riggles1/GunconDuino-With-Screen-Flash/README.md

# GunconDuino v2, With Trigger Screen Flash Support

PS1 Guncon controller as absolute Mouse coordinates via Arduino Pro Micro or Leonardo.
This repository is a fork based on the original work by Matheus Fraguas (sonik-br). 

The goal of this fork was to make the GunconDuino work with RetroArch's "shader (hold)" lightgun screen flash functionality.
This ensures XY-coordinates and trigger presses always get sent together. Meaning no more missed shots when shooting at dark areas, no matter how fast you shoot.
Due to emulation lag (setup+config dependent), the built-in flash in games doesn't work. This solution allows for any lightgun game to work when set up correctly. 

With this setup, the physical input lag of your intended shot direction is either sampled the same frame the trigger was pressed (if light is present) or up to 35ms (buffer delay, where screen flash happens), so the lag from a trigger press to XY position on screen is 0-2 frames (60Hz).

This script is set for 1-2 frames of input emu-lag (maximum at 60Hz, thanks to the bufferDelay that's set to 35ms. A maximum "2 frames".
There are alternate extended bufferdelay modes enabled by the A-button (at boot or after disabling the GunconDuino with A+B+Trigger), where bufferDelay becomes longer depending on how many times A was pressed before pulling the trigger.

 * Press A+B+Trigger to disable the guncon, then:
 * 0 A presses = default 2 frame bufferdelay, 
 1 A press = 3 frame bufferdelay, 
 2 A presses = 4 frame bufferdelay, 
 3 A presses = 5 frame bufferdelay, 
 4 A presses = 6 frame bufferdelay. 
 (60Hz frames)
 * Finally pull the trigger to confirm the selection. You can at any time disable it and select a different bufferdelay mode.
 * Set whatever bufferdelay depending on your setup lag, optimal setups will have 1-2 frames of input lag depending on the title, but for something like Carnevil that plays at 55Hz, use the 3 frame bufferdlay mode (1 A press) to compensate, since each frame takes longer at 55Hz.

To check that the GunconDuino isn't losing shots due to lag. Shoot repeatedly at a black spot in a game.

> NEW OPTIONAL FEATURE: Adding a Pedal input.
> By wiring something like a a 3.5mm port between GND and D6 on the Arduino Pro Micro and plugging in a generic ~$5 sustain pedal, you have an input that mirrors "middle mouse click/Guncon button B", useful for games like Time Crisis that made use of a pedal.

GunconDuino v2 in action: https://www.youtube.com/watch?v=mwm7y__UAsM 

My CRTEmudriver setup guide that I use for this can be found in the video description here: https://youtu.be/Fdo5z1mQ748

---

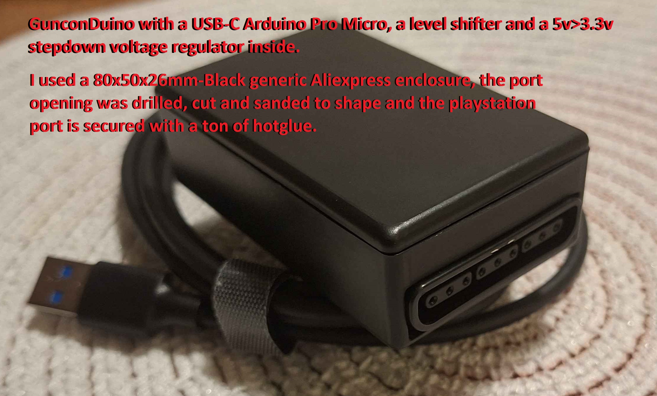
[picture p1: docs/Enclosure.jpg]
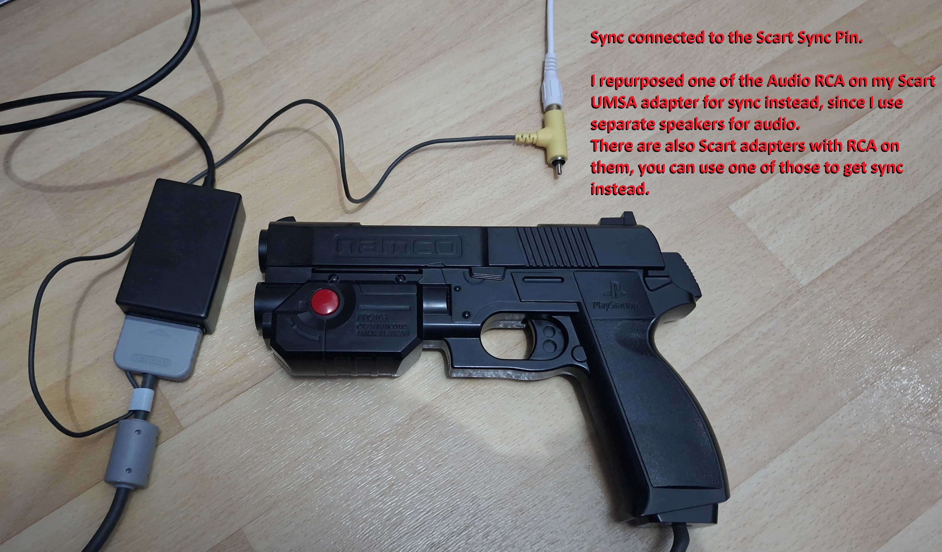
[picture p2: docs/GunconSync.jpg]
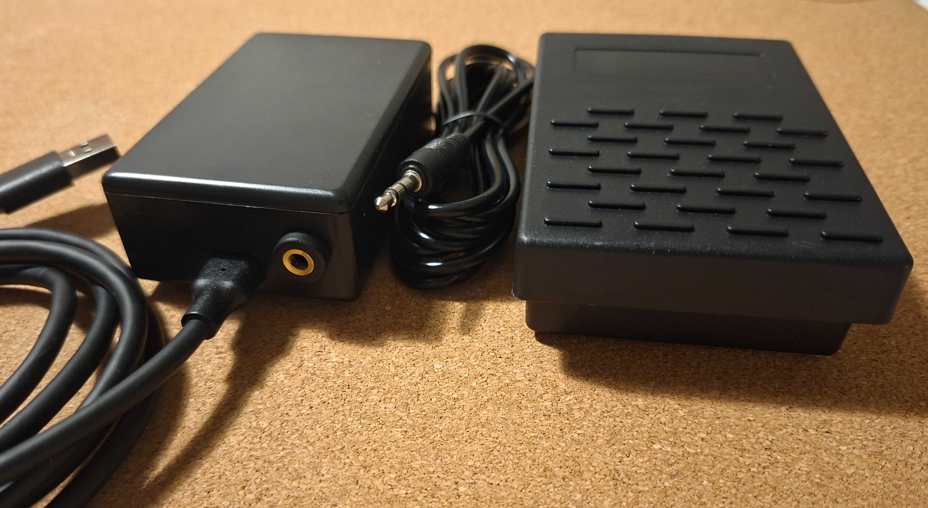
[picture p3: docs/3.5mmPedal.jpg]
   

---

## Software setup (RetroArch)

* In RetroArch Hotkeys map **"Shader (hold)"** to the keyboard key **L**.
* Choose a shader (example: `shaders/misc/color-mangler.slang`) and adjust brightness/gamma to taste.
* Save the shader for the game, then disable it in the game's override config: `video_shader_enable = "false"` in `gamename.cfg`.
* Use the **rawmouse** input driver, this allows using two GunconDuino units for 2-player games.
* Select the Arduino (might be called Leonardo) as your mouse device ID. 
* If playing a 480i game, disable the guncon first with the disable button combo, then boot up the game. Not doing this can result in the shot output only covering the top half of the screen.

### Latency and video driver recommendations

* Use native RGB output setups such as **CRTEmudriver** for minimal latency.
* Use  **d3d11** or **vulkan** as the video driver in RetroArch (setup and game dependent, I use both in my configs, all with optimal latency).
* Adjust `video_max_frame_latency = "0"`(used with d3d11, optimal value for most things) `video_max_swapchain_images = "2"` (used with vulkan, optimal value for most things). 
* The wrong values for the settings above can cost several frames of latency, check these values for individual games in the `Preset-configs\config/MAME\` folder.
* Try with and without frame delay, shoot at dark targets, shoot in the bottom right corner (it should always register).
* Change threaded rendering in both RA and the MAME core options+.ini.

Preset configs for this setup are included in the `Preset-configs` folder, copy or compare them with your own configs.

---

## Usage & mappings

**Calibration:** Start by standing from the distance you will play at, move the guncon across a fully lit screen fairly slowly (left-right, top-bottom) edge to edge to capture min/max screen values. 
Then repeat the process with the guncon pointing much closer to the screen. The most accurate readings will be from the first distance you calibrated at.
Once calibrated, press the trigger **10 times** to lock the calibration (the calibration will also lock itself at any point, whenever the lock counter reaches 10). 
If the Arduino is disconnected, it requires recalibration. Disable-reenable of the the guncon does not require recalibration.

Some games have their own built in calibration tool, often hidden within a service menu, look up how to do this is accessed on a per game basis. The provided savefiles in this project have my own calibrations, test with these.

**Trigger**: Left-Click (and keyboard "L" pulse for shader flash)

**A**: Right-Click

**B**: Middle-Click

**Press "Trigger"** after plugging or doing the disable combo: default buffer mode **35ms** maximum (for 60Hz 0-2 frame game lag, shots still release as soon as light is sensed within 0-35ms).

**Press "A" 1-4 times followed by "Trigger"** after plugging in or doing the disable combo: 1 A press = 3 frame bufferdelay, 2 A presses = 4 frame bufferdelay, 3 A presses = 5 frame bufferdelay, 6 A presses = 6 frame bufferdelay. (60Hz frame-time, 55Hz frames are longer, select a bufferdelay that's +1 in that case)

To **Disable/re-enable** the GunconDuino: Press A+B+Trigger to disable the GunconDuino (unsticks mouse controls), press either "Trigger" for the normal bufferdelay or "A" (1-4 times) then "Trigger" for either of the extended bufferdelays.

**XY-Freeze mode** (toggle): Hold "A + B" for 2 seconds to toggle infinite XY-Freeze. 
>This freezes XY-coordinates when light (XY) is lost and resumes XY-updates either as soon as the guncon can
>see light again, either something bright enough in the game or the trigger flash.
>
>  Useful for games that require continuous shooting, games that used IR or analog stick tracking originally (like Jurassic Park 1994, though honestly it still plays bad with this as that game was made for analog sticks).
>  It's  necessary for some other games such as Crypt Killer or Carnevil which has a gattling/machine gun that strobes the screen at a slow rate.
>  XY-freeze-mode makes it keep XY-coordinates in-between strobe flashes, so that XY is always there when the game asks for position.
>
> Adding a Pedal input.
> By wiring something like a a 3.5mm port between GND and D6 on the Arduino Pro Micro and plugging in a generic ~$5 sustain pedal, you have an input that mirrors "middle mouse click/Guncon button B", useful for games like Time Crisis that made use of a pedal.

**MAME / RetroArch mapping notes:**

* MAME lightgun games that used real lightguns (e.g. Point Blank) use **GunX** and **GunY**. `GUNCODE_1_XAXIS and GUNCODE_1_YAXIS` in `saves/mame/cfg/` the .cfg for the game.
* In `\system\mame\ini\mame.ini`, enable lightguns (not mouse). Use my included `mame.ini` if you don't have it.
* In the MAME core options, enable the .ini read (so it reads it).
* In RetroArch's MAME core input settings, map **GunX** and **GunY** (do NOT map as MouseX/MouseY).
* You will likely need to manually edit the RetroArch and MAME-core configs, mapping via the built-in configurators may not add the required lightgun axes.

**PCSX-ReARMed (PS1, RetroArch) mapping notes**
* This core supports rawinput mouse input for guncons, meaning two players are supported (I couldn't get guncons working with swanstation)
* Buttons are mapped to plugged in controllers as well the so that you can do the trigger+A+B combo through the controller to exit the arcade mode in Point Blank, as this combo is what otherwise disables the guncon.
* I've included what settings I use in order to make PS1 lightgun games never miss an input ```video_driver = "d3d11", video_max_frame_latency = "1, video_frame_delay_auto = "true, video_frame_delay = "3"```
* Runahead works with PCSX-ReARMed, I've set it to 1 in the configs included in this package.
* The following mappings are necessary for PCSX-ReArmed to recognize the trigger, A and B buttons. Inputs are also mirrored on the P1 and P2 controllers within the PCSX-ReARMed.cfg override in ```\config```.

**Flycast notes**
If the XY tracking is limited to the top portion of the screen, exit the game/core, disable the GunconDuino (A+B+Trigger), start the game again and enable the guncon while it's running (trigger press, or A button presses then trigger if selecting a different buffedelay).

Edit the PCSX-ReARMed.cfg accordingly (already set in the included config override):
```
//Guncon Player 1 Trigger mapping:
  input_player1_gun_trigger_mbtn = "1"   //mousebtn-left-click (mouse ID 1)
  input_player1_gun_trigger_btn = "3"

//Guncon Player 1 A button mapping:
  input_player1_gun_aux_a_mbtn = "2"   //mousebtn-right-click (mouse ID 1)
  input_player1_gun_aux_a_btn = "4"

//Guncon Player 1 B button mapping:
  input_player1_gun_aux_b_mbtn = "3"   //mousebtn-middle-click (mouse ID 1)
  input_player1_gun_aux_b_btn = "5"

//Guncon Player 2 Trigger mapping:
  input_player2_gun_trigger_mbtn = "1"   //mousebtn-left-click (mouse ID 2)
  input_player2_gun_trigger_btn = "3"

//Guncon Player 2 A button mapping:
  input_player2_gun_aux_a_mbtn = "2"   //mousebtn-right-click (mouse ID 2)
  input_player2_gun_aux_b_btn = "5"

//Guncon Player 2 B button mapping:
  input_player2_gun_aux_b_mbtn = "3"   //mousebtn-middle-click (mouse ID 2)
  input_player2_gun_aux_b_btn = "5"

//Guncon shader flash activation (any core, you can include this within an .cfg override instead, see example configs)
input_shader_hold = "l"
```

---

## How it works

* On any hardware trigger press the Arduino sends a keyboard **L** pulse (to trigger the shader flash) followed by a buffered mouse click so the game receives valid XY coordinates and a click.
* Trigger presses are continuously buffered, meaning that you can spam the trigger without missing shots even if your setup lag is 3 frames.
* If light is sensed before expected buffer release, it cancels the buffer and releases the shot instantly (the buffer is just a fallback, accommodating for laggier setups)
* The buffer releases at **35 ms**, which works with 1-2 frames of lag, but if you have to you can use any of the extended bufferdelay mode meant for lower Hz games like Carnevil (55Hz 256p). But only do this if you've fully optimized your setup and configs for lag first.
* Light sensing has a 35ms leniency window in case light is lost before the trigger press gets sent to the game (XY will always immediately update again at any frame light is sensed, it's just there if light is lost very momentarily, so there's zero latency drawbacks with this).

* The actual input sensing lag is 2 frames due to that being the exact moment when your physical aim+trigger is captured. However when shooting at dark targets the game will react 2 frames later after this input capture.
In the future maybe we could have a screen flasher that bypasses the 2 frame game render pipeline. 
That said with extensive testing and comparing Point Blank MAME with my real PS1, I can zip the aim left-right as fast as possible, firing at the edges and it'll always hit them, it shoots where I intend to at high speeds and never fails delivering the shot. Largely thanks to the actual moment XY is sampled for the trigger pull is either instantly (light target already there) or at most 35ms later (dark target), additional frames are just the game reacting to the input.

Dark target (with 2 frames of emulation input lag):

```
>Trigger press
>2 Frames emu-lag (input for shader)
>1 Frame flash, XY+Trigger states sent
>2 Frames emu-lag (inputs sent to game)
>Game reaction
```

Light target (with 2 frames of emulation input lag):
```
>Trigger press
Either: XY+Trigger states gotten and sent the same frame as the Trigger press.
(if the screen could be sampled this same frame, depends on how far the CRT has drawn the frame)
Or XY+Trigger states gotten 1 frame later instead.
>2 Frames emu-lag (inputs sent to game)
>Game reaction
```

However I've included an optimization where it will instantly send the trigger and XY states if the Guncon already has light before the flash shader.
Meaning that any moderately bright thing you aim at (a majority of targets), will be down to just 2-3 frames of input lag.
And it'll be down to just 1 frame IF the game is supported by runahead (set to 2).

---

## Misc minor improvements over original GunconDuino

* Buttons polled independently at maximum rate.
* Faster screen XY polling while preserving bottom-of-CRT sensing.
* 5ms debounce, preventing double trigger click and extra "L" key shader flash activation.
* A+B+Trigger disable can be peformed without pointing it at the screen, it also now ensures buttons don't get stuck.
* Max-min XY calibration locks after the trigger has been pressed 10 times (at any point the counter reaches 10 presses)
* External pedal support (momentary switch wired between D6 and GND)
---

## Build instructions

**Required hardware:**
* Arduino Pro Micro with USB C (recommended) or Arduino Leonardo
* PS1 accessories operate at **3.3V** (you must use a 5V → 3.3V regulator)
* Level shifter (required, without it the Guncon may be damaged over time)
* PS1/PS2 female connector 
* A suitable enclosure (I used a 80x50x26mm one)

(All of these parts are available on AliExpress)

You can custom build a circuit with a level shifter and voltage regulator, or get the shield below which integrates these components.

**Shield:**

* [https://github.com/SukkoPera/PsxControllerShield](https://github.com/SukkoPera/PsxControllerShield)

### If not using the shield (wiring with a playstation controller port, female connector):

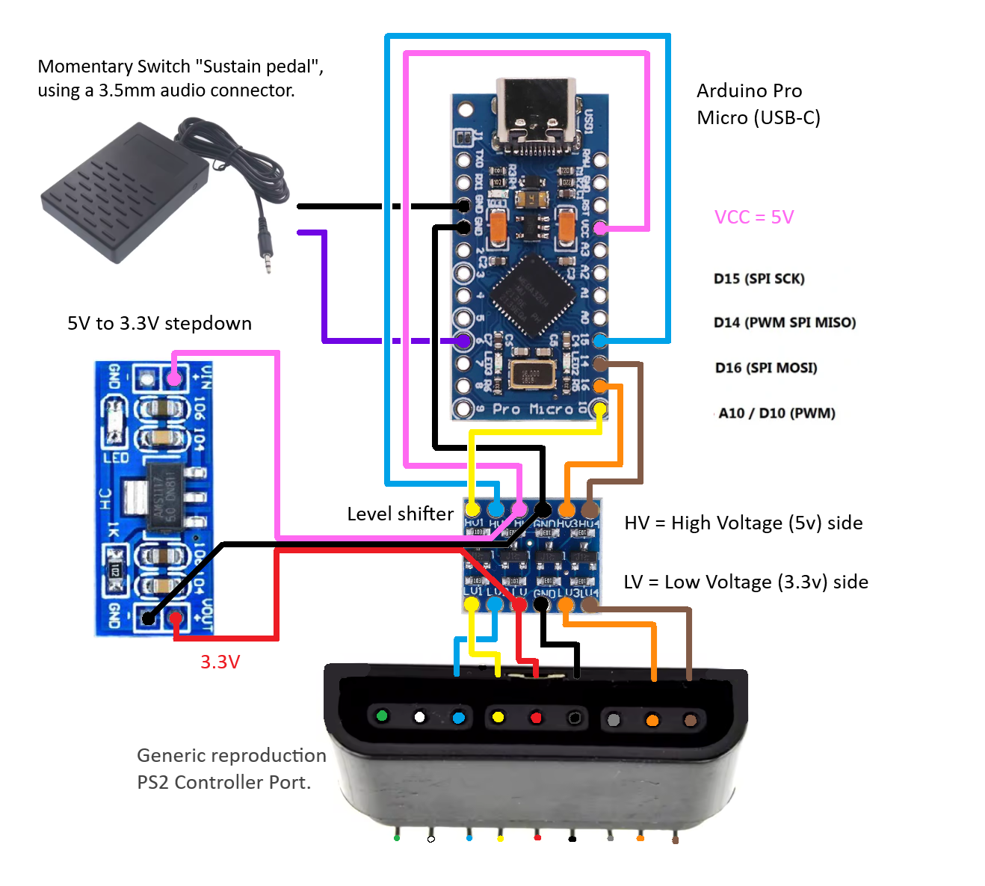
[picture p4: docs/schematics.png]
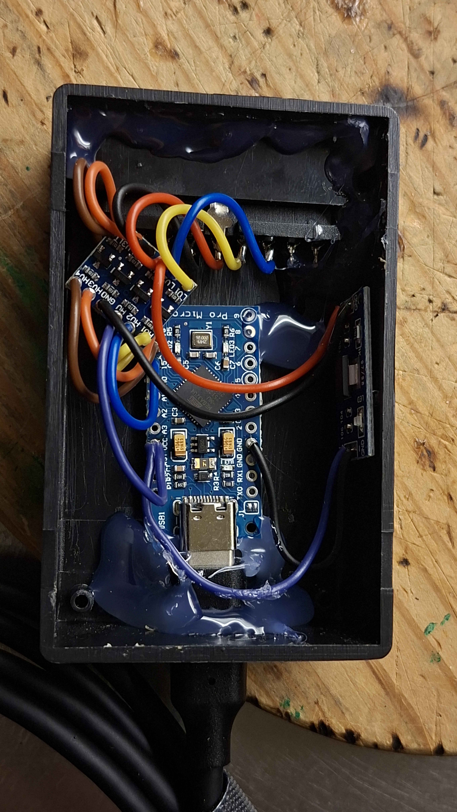
[picture p5: docs/Wiring.jpg]
 

The wiring inside a playstation controller cable, male connector, for reference.



### Flashing the script to the Arduino

**Libraries required:**

* [PsxNewLib](https://github.com/SukkoPera/PsxNewLib)
* [ArduinoJoystickLibrary](https://github.com/MHeironimus/ArduinoJoystickLibrary)

> I have included the libraries in this release. Remove duplicate copies from `ThisPC/Documents/Arduino/libraries/` if present.

* Flashing tip: If you have trouble flashing the `.ino` to a Pro Micro, try an older Arduino IDE version.

> Important: This project is intended for CRTs at standard resolutions and native output setups (CRTEmudriver or similar).

Official Guncons behave correctly, but third-party guns may produce incorrect readings (adjusting screen values in the script may help).

---

## Credits

* Original GunconDuino code by sonik-br: [https://github.com/sonik-br/GunconDuino](https://github.com/sonik-br/GunconDuino)
* PsxNewLib by SukkoPera: [https://github.com/SukkoPera/PsxNewLib](https://github.com/SukkoPera/PsxNewLib)
* Modified absmouse by jonathanedgecombe: [https://github.com/jonathanedgecombe/absmouse](https://github.com/jonathanedgecombe/absmouse)
* ArduinoJoystickLibrary by MHeironimus: [https://github.com/MHeironimus/ArduinoJoystickLibrary](https://github.com/MHeironimus/ArduinoJoystickLibrary)
* PS controller pinout reference by CuriousInventor: [https://store.curiousinventor.com/guides/PS2](https://store.curiousinventor.com/guides/PS2)

---
