riggles1/GunconDuino-With-Screen-Flash/(commit log)

2025-12-06 Refactor GunconDuino sketch for improved functionality
    Updated the GunconDuino sketch to enhance functionality and improve compatibility with various controllers. Added new features for calibration, button handling, and mouse/joystick emulation.
2025-12-06 Revise README for clarity and formatting improvements
    Updated README to improve clarity and formatting, including setup instructions, calibration process, and hardware requirements.
2025-12-06 Point Blank example config (Absolute GunX GunY mappings)
    [ptblank.cfg]
2025-12-06 Create default.cfg
    MAME global mappings (GunconDuino as GunX and GunY here, along with left-click as trigger in all gun games)
    [default.cfg]
2025-12-06 MAME global mappings (GunconDuino as GunXY as well as click for trigger in gun games)
    [default.cfg]
2025-12-06 Add ptblanks.cfg configuration file
    [ptblanks.cfg]
2025-12-06 Point Blank GunXY mapping config example
    [ptblank.cfg]
2025-12-06 Example RA config override for Point Blank (mame)
    [ptblank.cfg]
2025-12-06 Add light gun input ports to ptblank.cfg
    [ptblank.cfg]
2025-12-06 Guncode X and Y mappings (global mapping for lightguns to work)
    [default.cfg]
2025-12-10 Update README with wiring images and library requirements
2025-12-10 Add wiring reference image for PlayStation controller
    Added reference image for wiring inside a PlayStation controller cable.
2025-12-10 Add reference image for Playstation controller wiring
2025-12-10 Clarify wiring images section in README
2025-12-15 Update GunconDuino.ino
    Clicks buffered no matter how short the trigger press was. (with 5ms debounce)
    [GunconDuino.ino]
2025-12-16 Update GunconDuino.ino
    added XY clear on new trigger press (to prevent old carry over from causing a false early (within trigger hold) press.
    [GunconDuino.ino]
2025-12-16 Update ptblank.cfg
    2D games can be set to d3d11 (video driver set in this config)
    [ptblank.cfg]
2025-12-16 3D games should use vulkan
    driver set in this config
    [ghlpanic.cfg]
2025-12-16 2D games can use d3d11
    d3d11 set in config
    [ptblank.cfg]
2025-12-17 Update GunconDuino.ino
    Added L key debounce, prevents L from being sent twice (two shader flash frames in a row, now it's always 1)
    [GunconDuino.ino]
2025-12-21 Create Point Blank (USA).cfg
    [Point Blank (USA).cfg]
2025-12-21 Update Point Blank (USA).cfg
    [Point Blank (USA).cfg]
2025-12-21 Update Rescue Shot (60Hz by Static v1.01).cfg
    [Rescue Shot (60Hz by Static v1.01).cfg]
2025-12-24 Create Rescue Shot (60Hz by Static v1.01).rmp
2025-12-27 Update button mappings in default.cfg
    [default.cfg]
2025-12-27 Modify input ports for player controls
    Updated input ports for player controls in ptblank.cfg.
    [ptblank.cfg]
2025-12-27 save files with calibration done
    These are just save files
2025-12-28 Modify carnevil.cfg input settings
    Updated input mappings for player 2 and adjusted other settings.
    [carnevil.cfg]
2025-12-28 Update carnevil.cfg with new input mappings
    [carnevil.cfg]
2025-12-29 Update carnevil.cfg with new video and audio settings
    [carnevil.cfg]
2025-12-29 Refactor carnevil.cfg for clarity and organization
    [carnevil.cfg]
2025-12-29 Set video_max_frame_latency to 0
    [ptblank3.cfg]
2026-03-13 Added pedal support on Pin D6
2026-03-13 Added external pedal input (3,5mm jack)
